ArcaneNibble/jlc-katzen/README.md

# Just testing JLCPCB turn-key assembly with a blinky toy

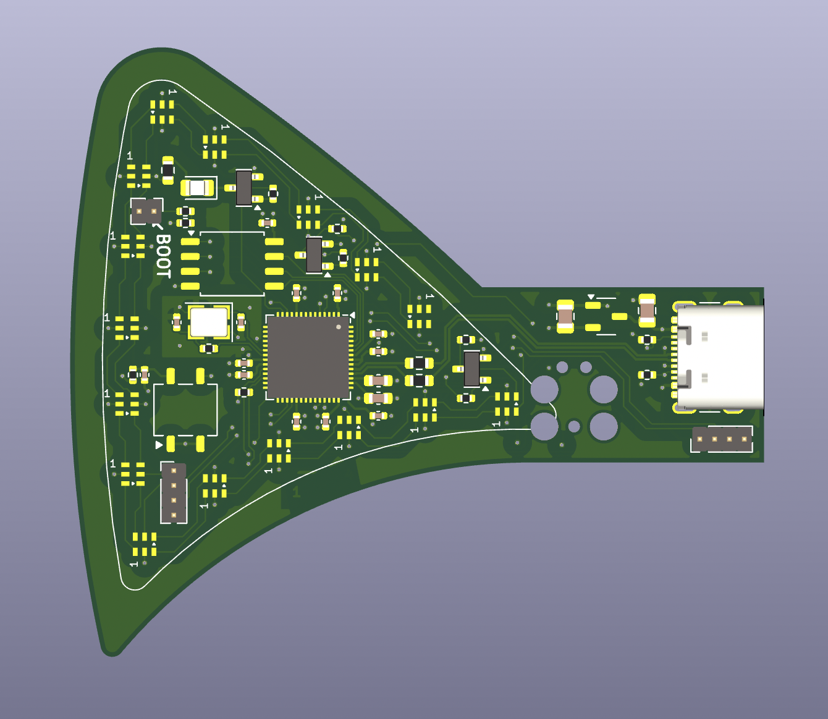
[picture p1: render.png]
rendered PCB


## ERRATA

* USB D+/D- are flipped!
* wrong crystal load capacitors
