ArcaneNibble/jlc-katzen/jlc-katzen.kicad_pcb

## KiCad design jlc-katzen.kicad_pcb (2024-09-04)

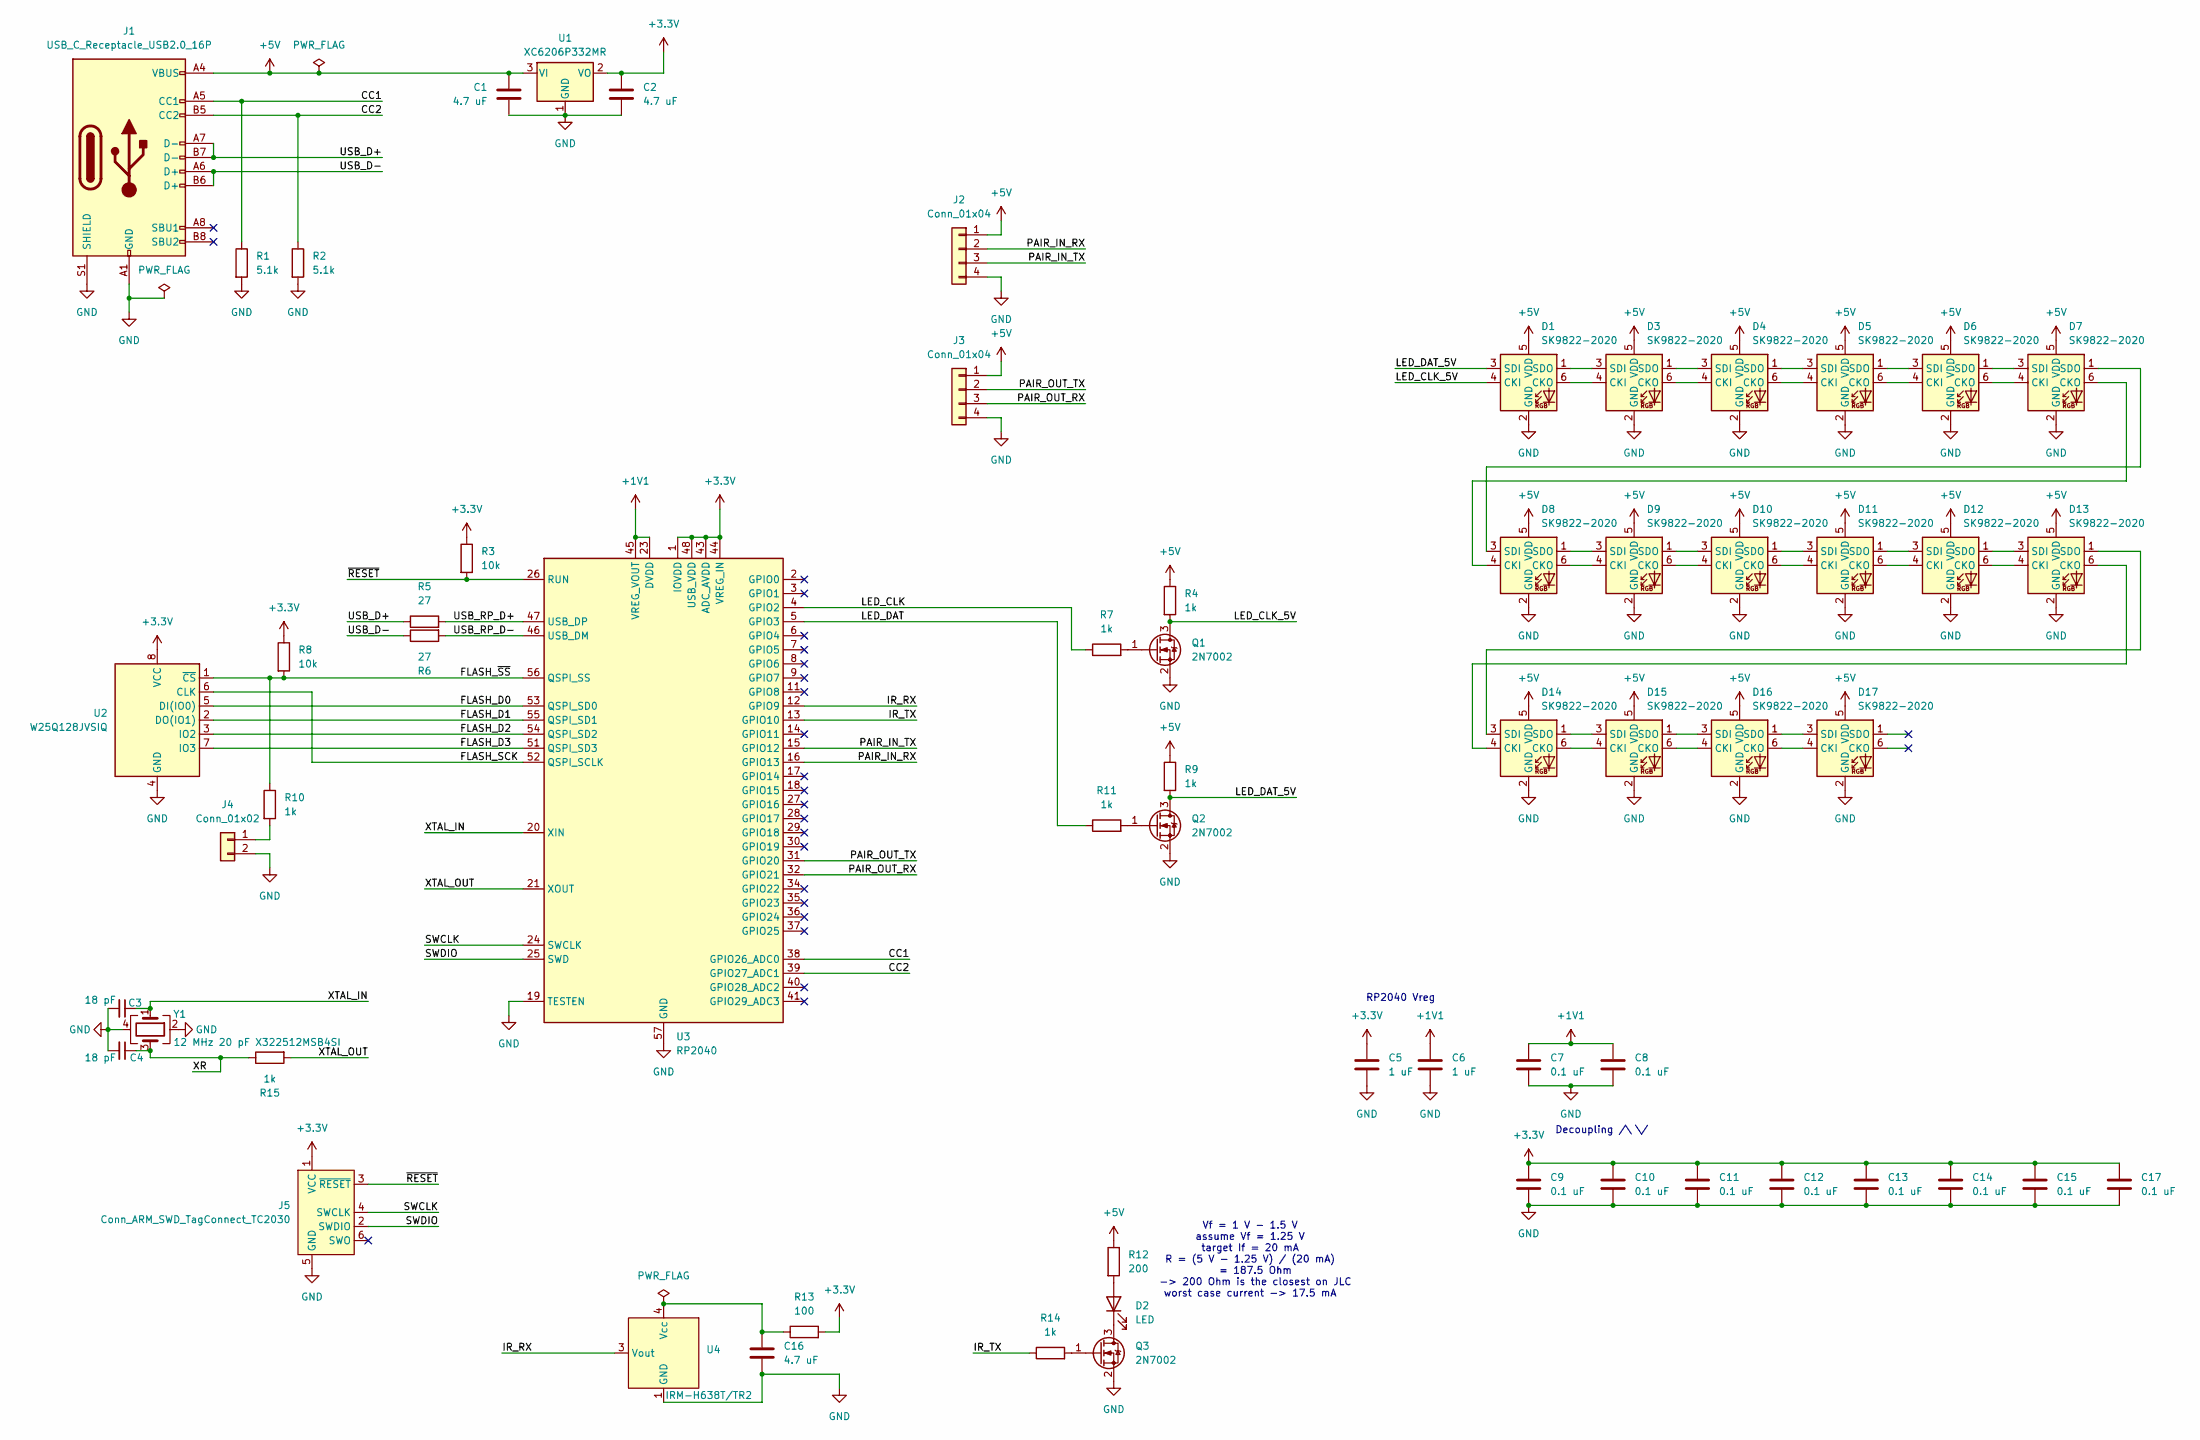
[picture p2: schematic jlc-katzen.kicad_sch, JLCPCB Katzenohren assembly practice board]

Parts:
C1, C2: 4.7 uF; C_0805_2012Metric; LCSC C1779
C3, C4: 18 pF; C_0402_1005Metric; LCSC C1549
C5, C6: 1 uF; C_0603_1608Metric; LCSC C15849
C7, C8, C9, C10, C11, C12, C13, C14, C15, C17: 0.1 uF; C_0402_1005Metric; LCSC C1525
C16: 4.7 uF; C_0402_1005Metric; LCSC C23733
D1, D3, D4, D5, D6, D7, D8, D9, D10, D11, D12, D13, D14, D15, D16, D17: SK9822-2020; LED-SK9822-2020; LCSC C2909059
D2: LED; LED_0805_2012Metric; LCSC C131250
J1: USB_C_Receptacle_USB2.0_16P; USB_C_Receptacle_GCT_USB4105-xx-A_16P_TopMnt_Horizontal; LCSC C2765186
J2, J3: Conn_01x04; PinHeader_1x04_P1.27mm_Vertical
J4: Conn_01x02; PinHeader_1x02_P1.27mm_Vertical
J5: Conn_ARM_SWD_TagConnect_TC2030; Tag-Connect_TC2030-IDC-FP_2x03_P1.27mm_Vertical
Q1, Q2, Q3: 2N7002; SOT-23; LCSC C7420321
R1, R2: 5.1k; R_0402_1005Metric; LCSC C25905
R3, R8: 10k; R_0402_1005Metric; LCSC C25744
R4, R7, R9, R10, R11, R14, R15: 1k; R_0402_1005Metric; LCSC C11702
R5, R6: 27; R_0603_1608Metric; LCSC C25190
R12: 200; R_0603_1608Metric; LCSC C8218
R13: 100; R_0402_1005Metric; LCSC C25076
U1: XC6206P332MR; SOT-23-3; LCSC C5446
U2: W25Q128JVSIQ; SOIC-8_5.23x5.23mm_P1.27mm; LCSC C97521
U3: RP2040; QFN-56-1EP_7x7mm_P0.4mm_EP3.2x3.2mm; LCSC C2040
U4: IRM-H638T/TR2; IRM-H6XXT; LCSC C91447
Y1: 12 MHz 20 pF X322512MSB4SI; Crystal_SMD_3225-4Pin_3.2x2.5mm; LCSC C9002

Connections:
+1V1: C6.1, C7.1, C8.1, U3.23 (DVDD), U3.45 (VREG_VOUT), U3.50 (DVDD)
+3.3V: C2.1, C5.1, C9.1, C10.1, C11.1, C12.1, C13.1, C14.1, C15.1, C17.1, J5.1 (VCC), R3.1, R8.1, R13.2, U1.2 (VO), U2.8 (VCC), U3.1 (IOVDD), U3.10 (IOVDD), U3.22 (IOVDD), U3.33 (IOVDD), U3.42 (IOVDD), U3.43 (ADC_AVDD), U3.44 (VREG_IN), U3.48 (USB_VDD), U3.49 (IOVDD)
+5V: C1.1, D1.5 (VDD), D3.5 (VDD), D4.5 (VDD), D5.5 (VDD), D6.5 (VDD), D7.5 (VDD), D8.5 (VDD), D9.5 (VDD), D10.5 (VDD), D11.5 (VDD), D12.5 (VDD), D13.5 (VDD), D14.5 (VDD), D15.5 (VDD), D16.5 (VDD), D17.5 (VDD), J1.A4 (VBUS), J1.A9 (VBUS), J1.B4 (VBUS), J1.B9 (VBUS), J2.1, J3.1, R4.1, R9.1, R12.1, U1.3 (VI)
/CC1: J1.A5 (CC1), R1.1, U3.38 (GPIO26_ADC0)
/CC2: J1.B5 (CC2), R2.1, U3.39 (GPIO27_ADC1)
/FLASH_D0: U2.5 (DI(IO0)), U3.53 (QSPI_SD0)
/FLASH_D1: U2.2 (DO(IO1)), U3.55 (QSPI_SD1)
/FLASH_D2: U2.3 (IO2), U3.54 (QSPI_SD2)
/FLASH_D3: U2.7 (IO3), U3.51 (QSPI_SD3)
/FLASH_SCK: U2.6 (CLK), U3.52 (QSPI_SCLK)
/FLASH_~SS: R8.2, R10.1, U2.1 (~CS), U3.56 (QSPI_SS)
/IR_RX: U3.12 (GPIO9), U4.3 (Vout)
/IR_TX: R14.1, U3.13 (GPIO10)
/LED_CLK: R7.1, U3.4 (GPIO2)
/LED_CLK_5V: D1.4 (CKI), Q1.3 (D), R4.2
/LED_DAT: R11.1, U3.5 (GPIO3)
/LED_DAT_5V: D1.3 (SDI), Q2.3 (D), R9.2
/PAIR_IN_RX: J2.2, U3.16 (GPIO13)
/PAIR_IN_TX: J2.3, U3.15 (GPIO12)
/PAIR_OUT_RX: J3.3, U3.32 (GPIO21)
/PAIR_OUT_TX: J3.2, U3.31 (GPIO20)
/SWCLK: J5.4 (SWCLK), U3.24 (SWCLK)
/SWDIO: J5.2 (SWDIO), U3.25 (SWD)
/USB_D+: J1.A7 (D-), J1.B7 (D-), R5.1
/USB_D-: J1.A6 (D+), J1.B6 (D+), R6.1
/USB_RP_D+: R5.2, U3.47 (USB_DP)
/USB_RP_D-: R6.2, U3.46 (USB_DM)
/XR: C4.1, R15.1, Y1.3
/XTAL_IN: C3.1, U3.20 (XIN), Y1.1
/XTAL_OUT: R15.2, U3.21 (XOUT)
/~RESET: J5.3 (~RESET), R3.2, U3.26 (RUN)
GND: C1.2, C2.2, C3.2, C4.2, C5.2, C6.2, C7.2, C8.2, C9.2, C10.2, C11.2, C12.2, C13.2, C14.2, C15.2, C16.2, C17.2, D1.2 (GND), D3.2 (GND), D4.2 (GND), D5.2 (GND), D6.2 (GND), D7.2 (GND), D8.2 (GND), D9.2 (GND), D10.2 (GND), D11.2 (GND), D12.2 (GND), D13.2 (GND), D14.2 (GND), D15.2 (GND), D16.2 (GND), D17.2 (GND), J1.A1 (GND), J1.A12 (GND), J1.B1 (GND), J1.B12 (GND), J1.S1 (SHIELD), J2.4, J3.4, J4.2, J5.5 (GND), Q1.2 (S), Q2.2 (S), Q3.2 (S), R1.2, R2.2, U1.1 (GND), U2.4 (GND), U3.19 (TESTEN), U3.57 (GND), U4.1 (GND), U4.2 (GND), Y1.2, Y1.4
unnamed: D1.6 (CKO), D3.4 (CKI)
unnamed: D1.1 (SDO), D3.3 (SDI)
unnamed: D2.2 (A), R12.2
unnamed: D2.1 (K), Q3.3 (D)
unnamed: D3.6 (CKO), D4.4 (CKI)
unnamed: D3.1 (SDO), D4.3 (SDI)
unnamed: D4.6 (CKO), D5.4 (CKI)
unnamed: D4.1 (SDO), D5.3 (SDI)
unnamed: D5.6 (CKO), D6.4 (CKI)
unnamed: D5.1 (SDO), D6.3 (SDI)
unnamed: D6.6 (CKO), D7.4 (CKI)
unnamed: D6.1 (SDO), D7.3 (SDI)
unnamed: D7.6 (CKO), D8.4 (CKI)
unnamed: D7.1 (SDO), D8.3 (SDI)
unnamed: D8.6 (CKO), D9.4 (CKI)
unnamed: D8.1 (SDO), D9.3 (SDI)
unnamed: D9.6 (CKO), D10.4 (CKI)
unnamed: D10.6 (CKO), D11.4 (CKI)
unnamed: D9.1 (SDO), D10.3 (SDI)
unnamed: D10.1 (SDO), D11.3 (SDI)
unnamed: D11.6 (CKO), D12.4 (CKI)
unnamed: D11.1 (SDO), D12.3 (SDI)
unnamed: D12.6 (CKO), D13.4 (CKI)
unnamed: D12.1 (SDO), D13.3 (SDI)
unnamed: D13.6 (CKO), D14.4 (CKI)
unnamed: D13.1 (SDO), D14.3 (SDI)
unnamed: D14.6 (CKO), D15.4 (CKI)
unnamed: D14.1 (SDO), D15.3 (SDI)
unnamed: D15.6 (CKO), D16.4 (CKI)
unnamed: D15.1 (SDO), D16.3 (SDI)
unnamed: D16.6 (CKO), D17.4 (CKI)
unnamed: D16.1 (SDO), D17.3 (SDI)
unnamed: J4.1, R10.2
unnamed: Q1.1 (G), R7.2
unnamed: Q2.1 (G), R11.2
unnamed: Q3.1 (G), R14.2
unnamed: C16.1, R13.1, U4.4 (Vcc)

Notes on the sheet:
Vf = 1 V - 1.5 V assume Vf = 1.25 V target If = 20 mA R = (5 V - 1.25 V) / (20 mA) = 187.5 Ohm -> 200 Ohm is the closest on JLC worst case current -> 17.5 mA
RP2040 Vreg
Decoupling /\ \/

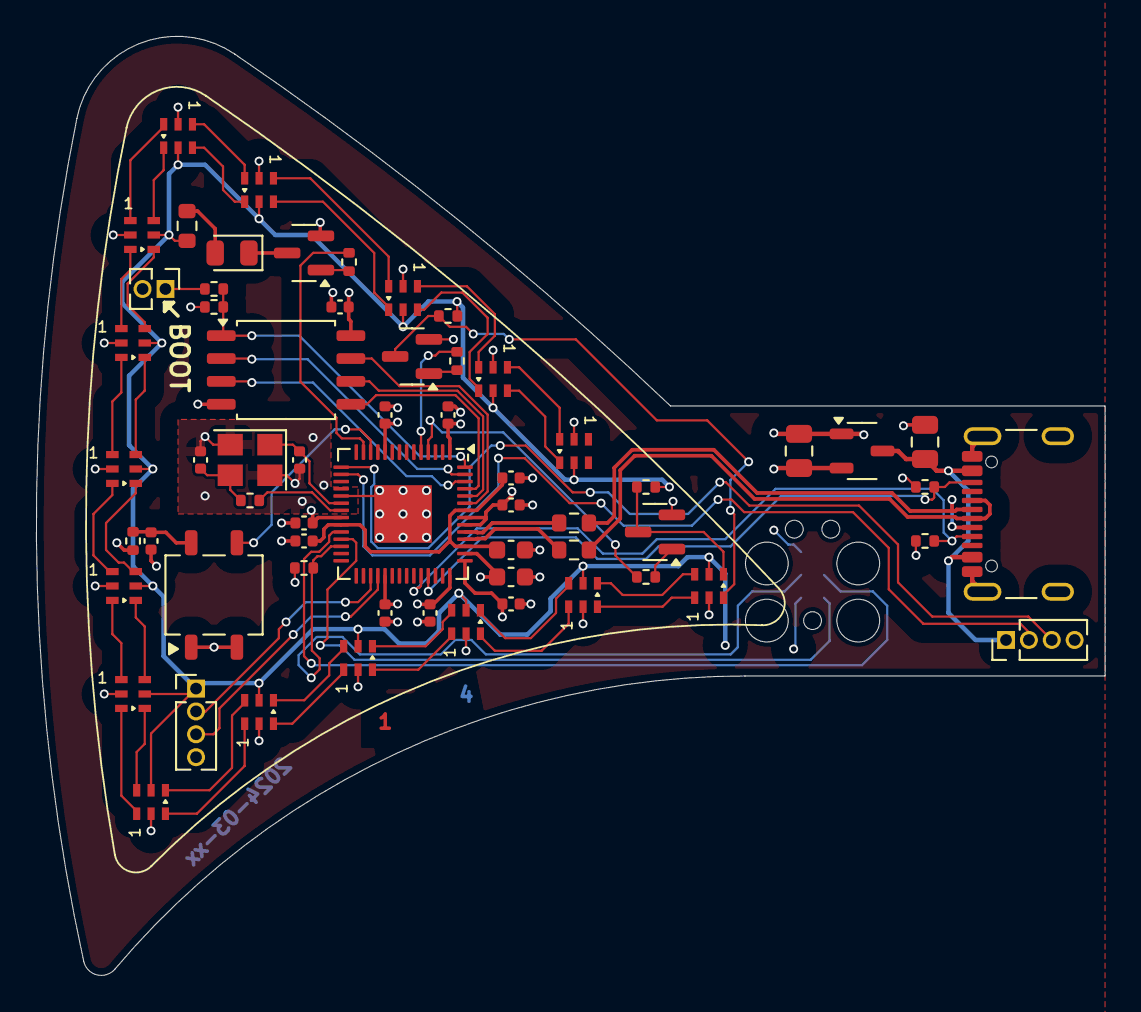
[picture p3: board jlc-katzen.kicad_pcb from above]

Board: 4 copper layers, 59.4 x 52.2 mm, 62 parts (1 on the bottom side), 69 nets.
