ArcaneNibble/jlc-katzen/(commit log)

2024-03-15 throw on basic parts
    [jlc-katzen.kicad_sch]
2024-03-15 draft sch
    [jlc-katzen.kicad_sch]
2024-03-15 ir rx footprint
2024-03-15 footprints, part numbers
    [jlc-katzen.kicad_sch]
2024-03-15 throw parts on a pcb of some kind
    [jlc-katzen.kicad_pcb]
2024-03-15 useless twiddles
    [jlc-katzen.kicad_pcb]
2024-03-15 fix crystal
    [jlc-katzen.kicad_pcb, jlc-katzen.kicad_sch]
2024-03-15 fix sk9822 footprint
2024-03-15 name some nets
    [jlc-katzen.kicad_pcb, jlc-katzen.kicad_sch]
2024-03-15 hopefully fit this many leds
    [jlc-katzen.kicad_pcb, jlc-katzen.kicad_sch]
2024-03-16 rough route
    [jlc-katzen.kicad_pcb]
2024-03-16 all nets connected
    [jlc-katzen.kicad_pcb, jlc-katzen.kicad_sch]
2024-03-16 mark unused
    [jlc-katzen.kicad_pcb, jlc-katzen.kicad_sch]
2024-03-16 clean traces, hide refdes on silk
    [jlc-katzen.kicad_pcb]
2024-03-16 clean silk, tweak traces more
    [jlc-katzen.kicad_pcb]
2024-03-16 more silk, tweaks
    [jlc-katzen.kicad_pcb]
2024-03-16 move ir tx/rx to separate pwm blocks
    (even if we use PIO instead)
    [jlc-katzen.kicad_pcb, jlc-katzen.kicad_sch]
2024-03-16 make labels on sch attach to ends of wires
    [jlc-katzen.kicad_sch]
2024-03-16 fix sch metadata
    [jlc-katzen.kicad_sch]
2024-03-17 fix pcb metadata
    [jlc-katzen.kicad_pcb]
2024-03-17 add thieving
    [jlc-katzen.kicad_pcb]
2024-03-17 plot A1
    [jlc-katzen.kicad_pcb]
2024-03-17 thieving coverage not sufficient -> fill
    [jlc-katzen.kicad_pcb]
2024-03-17 tweak fills
    [jlc-katzen.kicad_pcb]
2024-09-04 xxx changes to files
    [jlc-katzen.kicad_pcb]
